Nicofran83/Proy_Final_NF/imag_readme/Imagen22.jpg

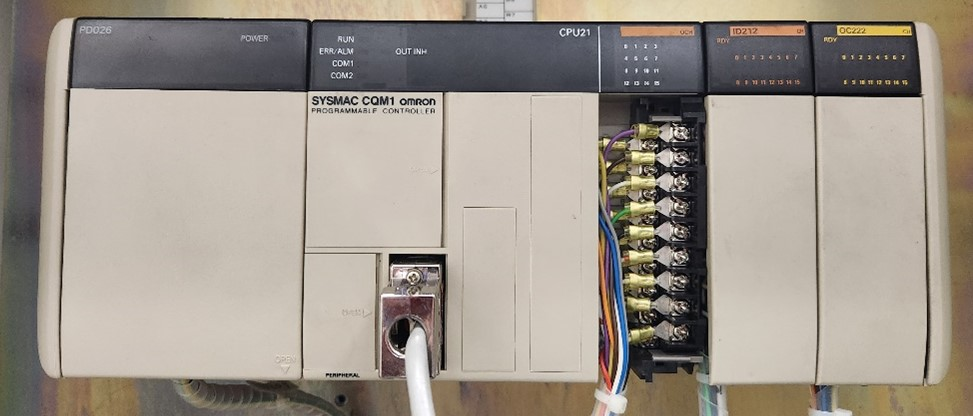
imag_readme/Imagen22.jpg
