Nicofran83/Proy_Final_NF/imag_readme/Imagen1.png

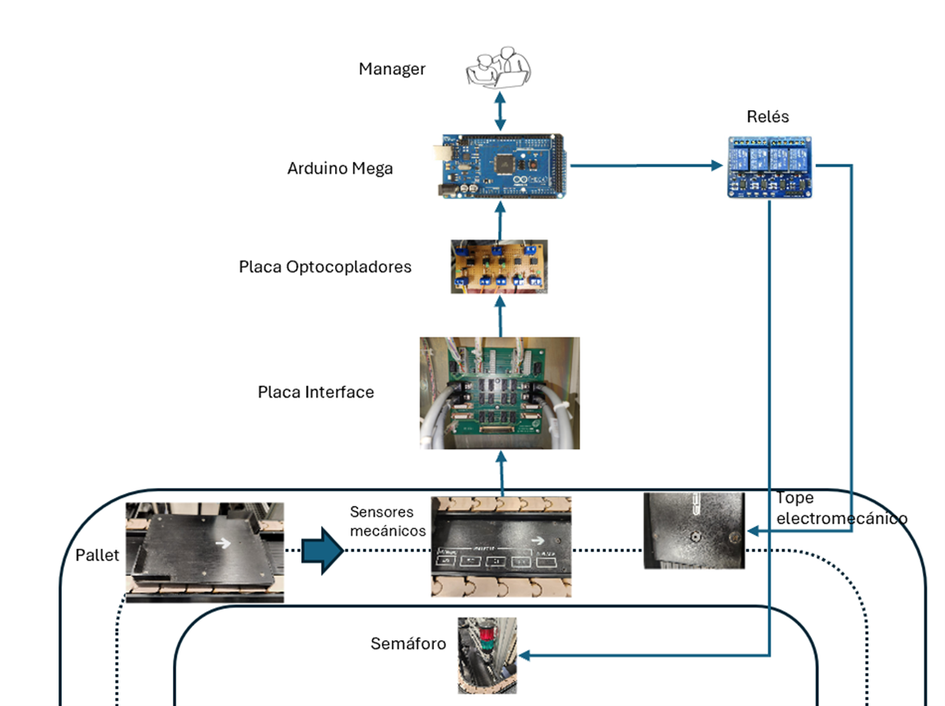
imag_readme/Imagen1.png
