Nicofran83/Proy_Final_NF/imag_readme/Imagen2.png

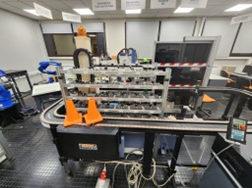
imag_readme/Imagen2.png
