Nicofran83/Proy_Final_NF/imag_readme/Imagen4.png

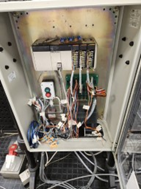
imag_readme/Imagen4.png
