Nicofran83/Proy_Final_NF/imag_readme/Imagen5.png

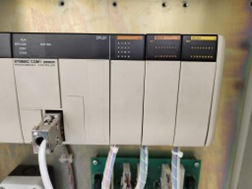
imag_readme/Imagen5.png
