Nicofran83/Proy_Final_NF/imag_readme/Imagen6.png

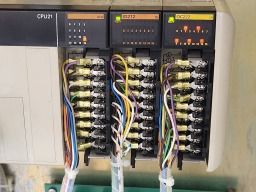
imag_readme/Imagen6.png
