Nicofran83/Proy_Final_NF/imag_readme/Imagen7.png

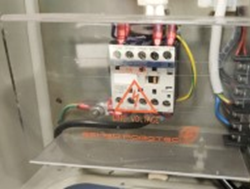
imag_readme/Imagen7.png
