Nicofran83/Proy_Final_NF/imag_readme/Imagen8.png

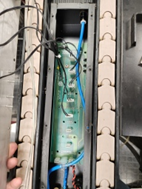
imag_readme/Imagen8.png
