Nicofran83/Proy_Final_NF/imag_readme/Imagen9.png

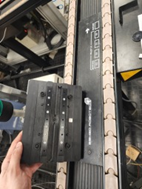
imag_readme/Imagen9.png
