Nicofran83/Proy_Final_NF/imag_readme/Imagen10.png

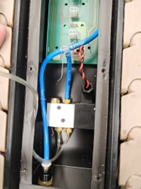
imag_readme/Imagen10.png
