Nicofran83/Proy_Final_NF/imag_readme/Imagen12.png

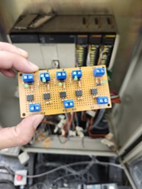
imag_readme/Imagen12.png
