Nicofran83/Proy_Final_NF/imag_readme/Imagen15.png

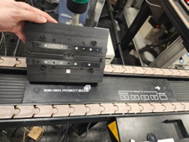
imag_readme/Imagen15.png
