Nicofran83/Proy_Final_NF/imag_readme/Imagen23.png

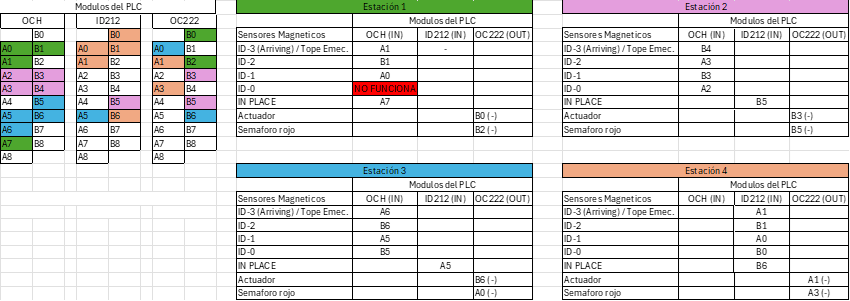
imag_readme/Imagen23.png
