Nicofran83/Proy_Final_NF/imag_readme/Imagen24.png

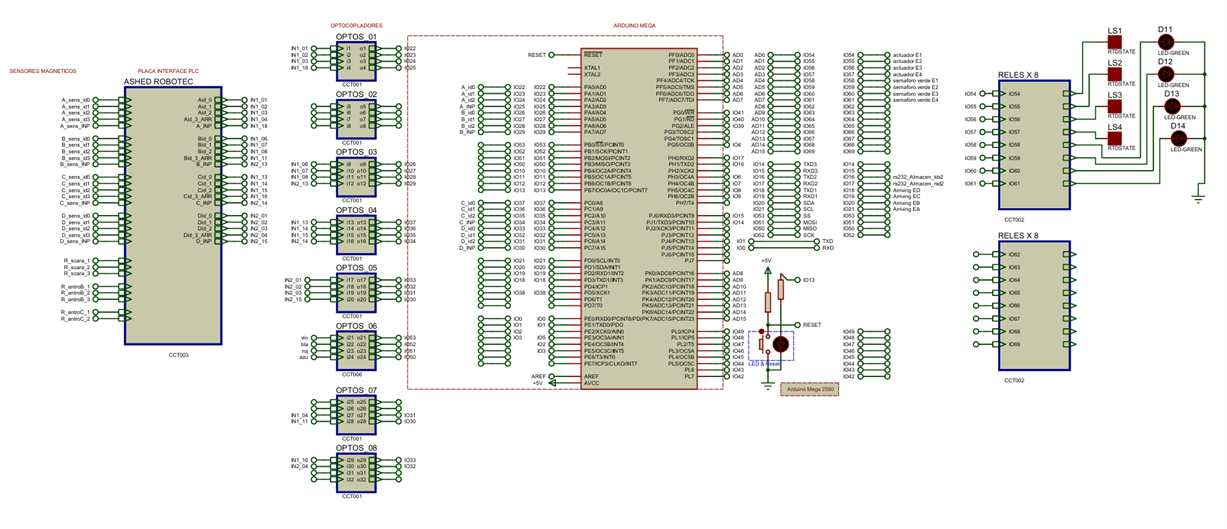
imag_readme/Imagen24.png
