Nicofran83/Proy_Final_NF/imag_readme/Imagen25.png

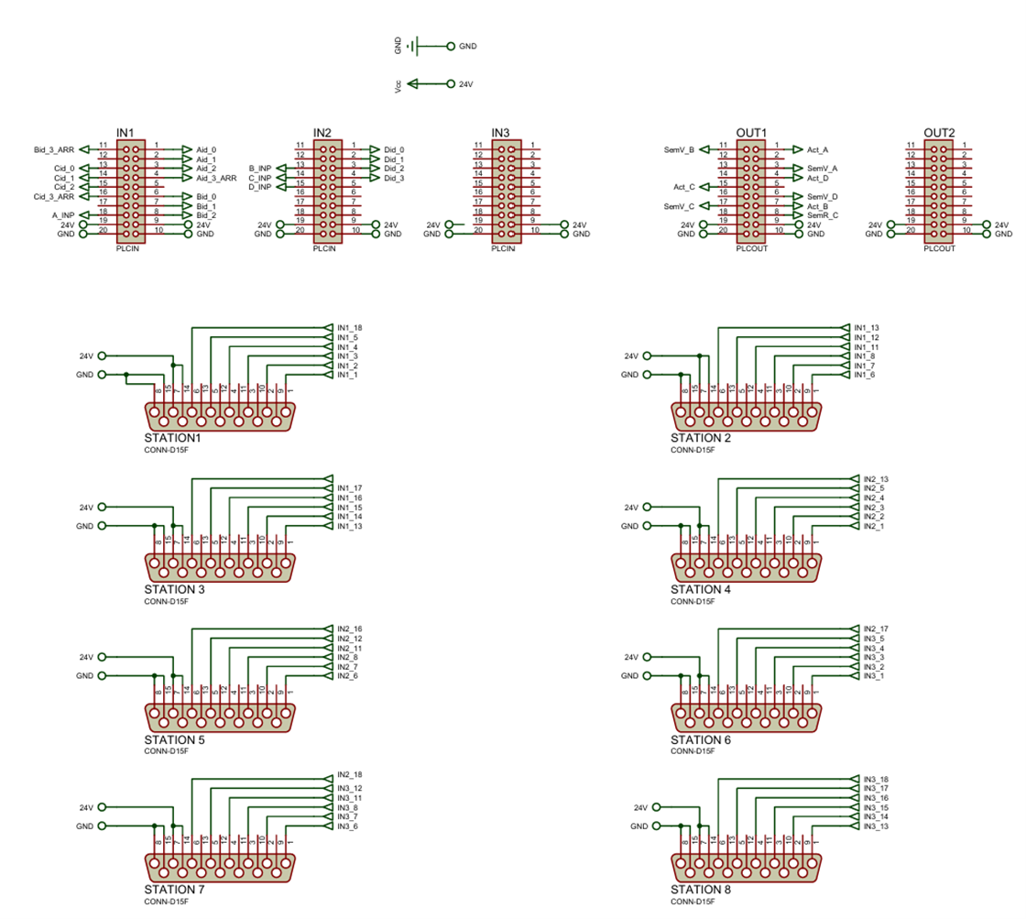
imag_readme/Imagen25.png
