Nicofran83/Proy_Final_NF/imag_readme/Imagen26.png

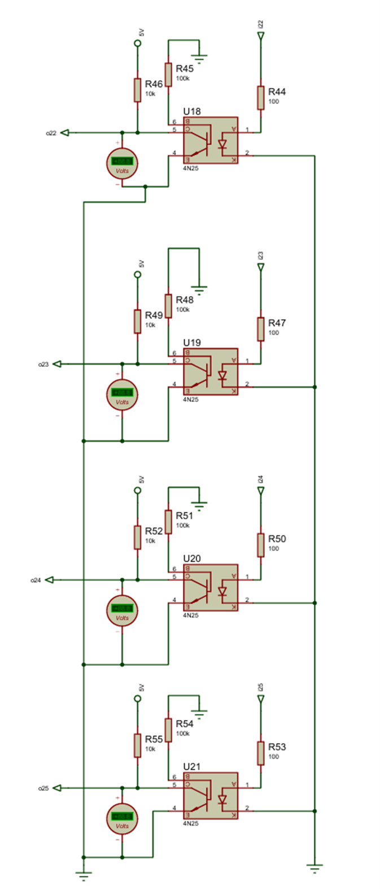
imag_readme/Imagen26.png
