Nicofran83/Proy_Final_NF/imag_readme/Imagen27.png

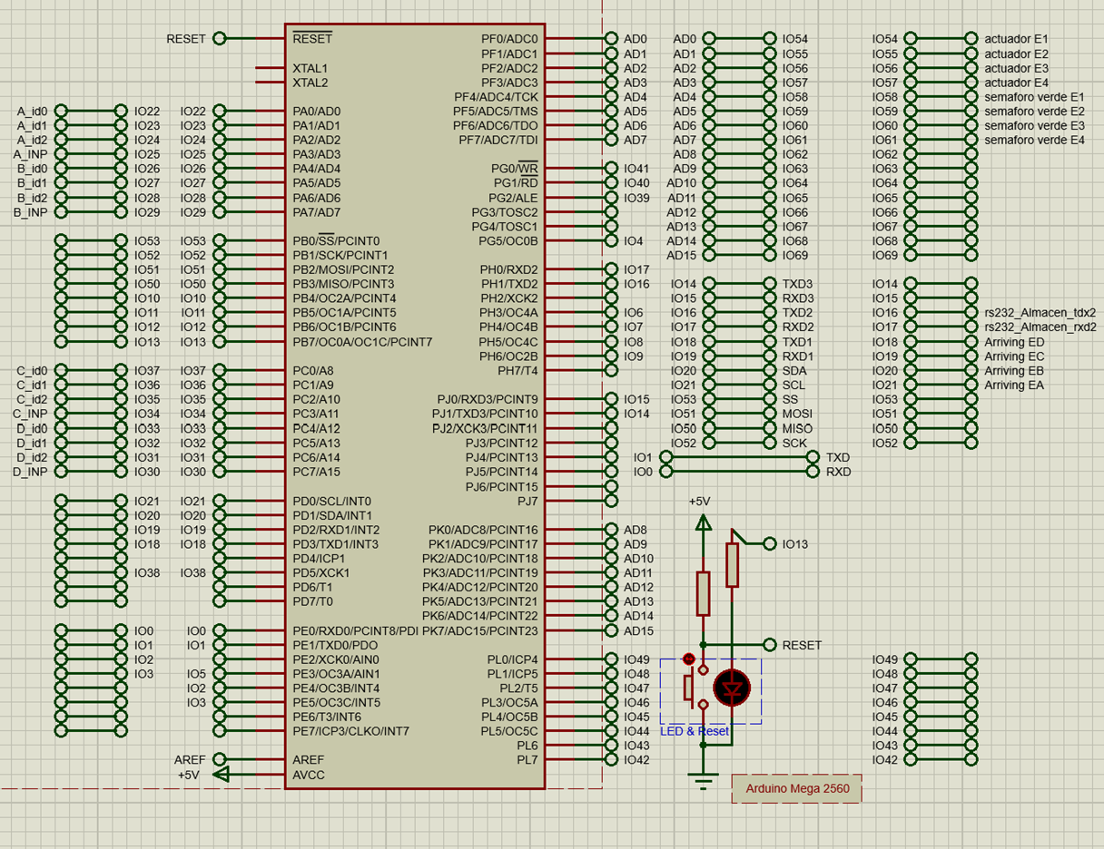
imag_readme/Imagen27.png
