Nicofran83/Proy_Final_NF/imag_readme/Imagen28.png

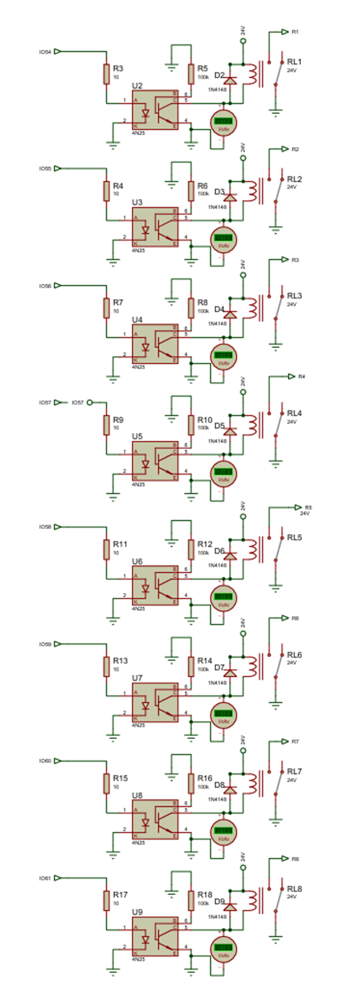
imag_readme/Imagen28.png
