Nicofran83/Proy_Final_NF/imag_readme/Imagen29.png

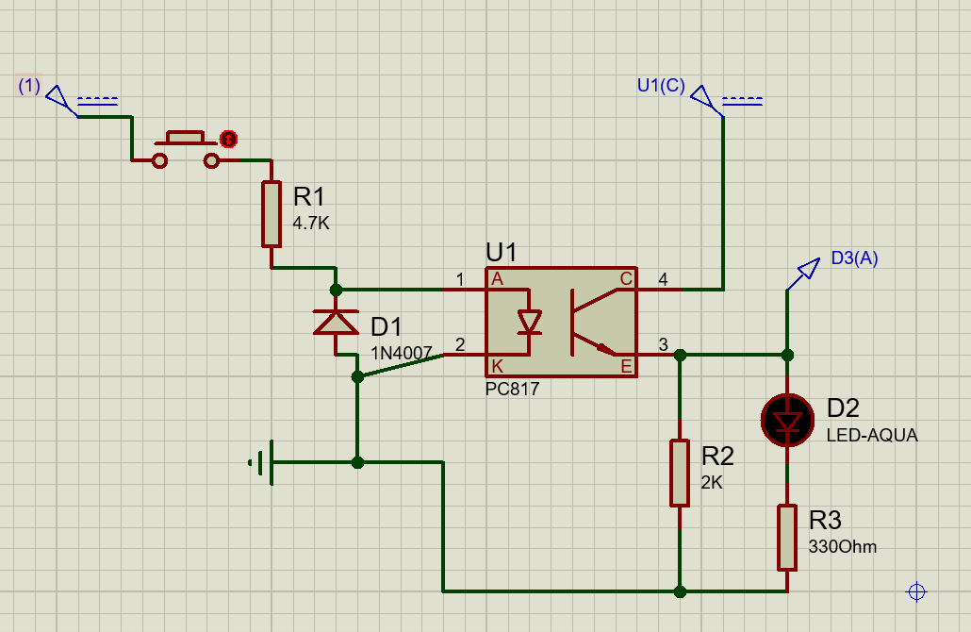
imag_readme/Imagen29.png
