Nicofran83/Proy_Final_NF/Imagenes/CIM/20240624_185640.jpg

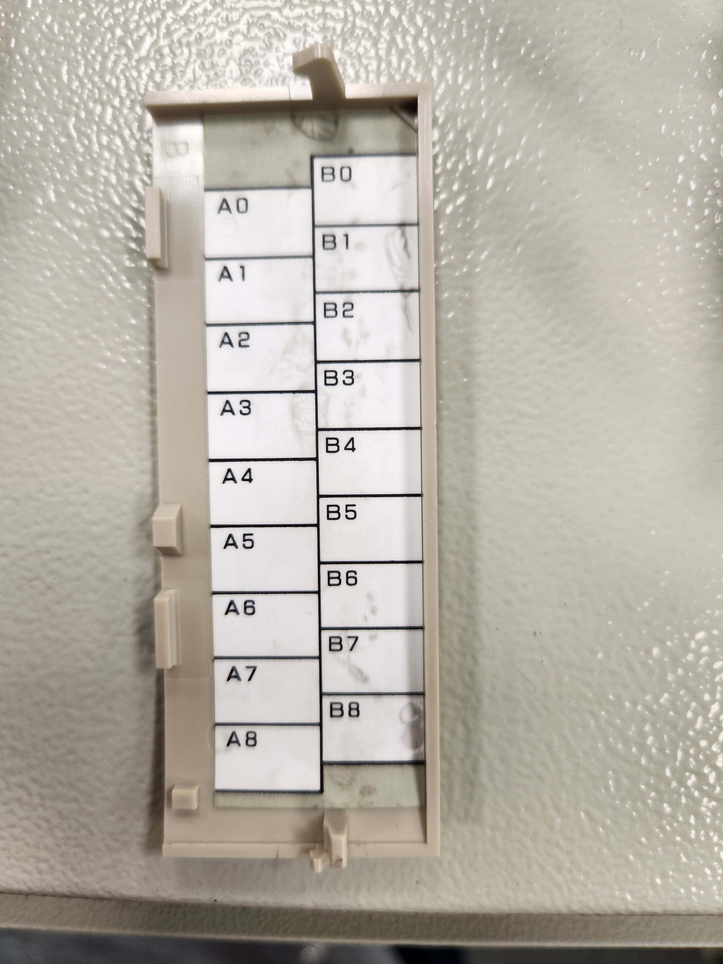
Imagenes/CIM/20240624_185640.jpg
