Nicofran83/Proy_Final_NF/Imagenes/CIM/20240624_201300.jpg

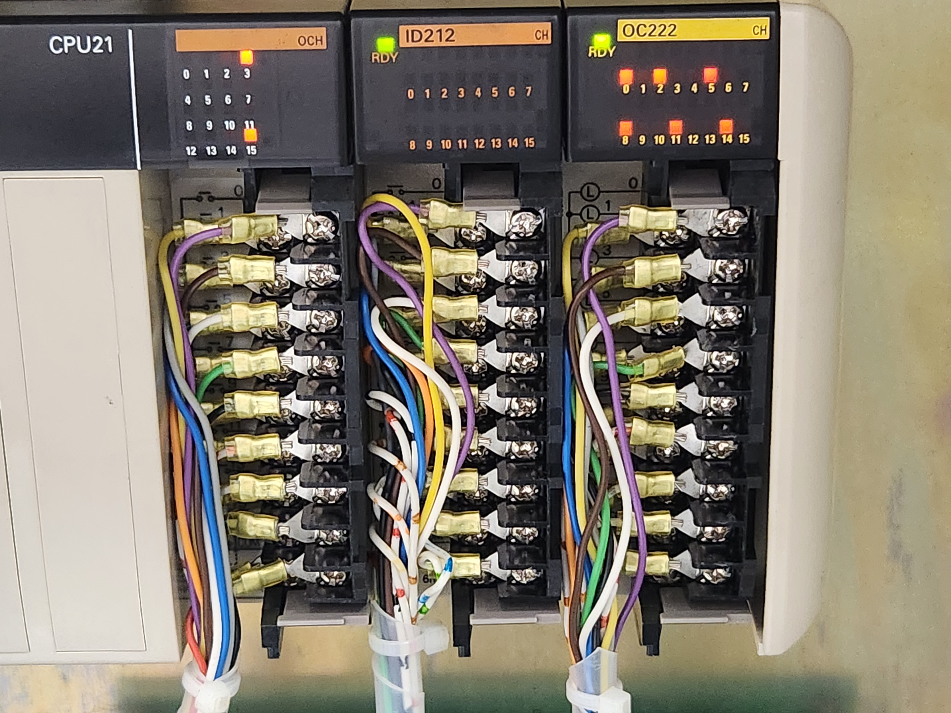
Imagenes/CIM/20240624_201300.jpg
