Nicofran83/Proy_Final_NF/Imagenes/CIM/20240708_185859.jpg

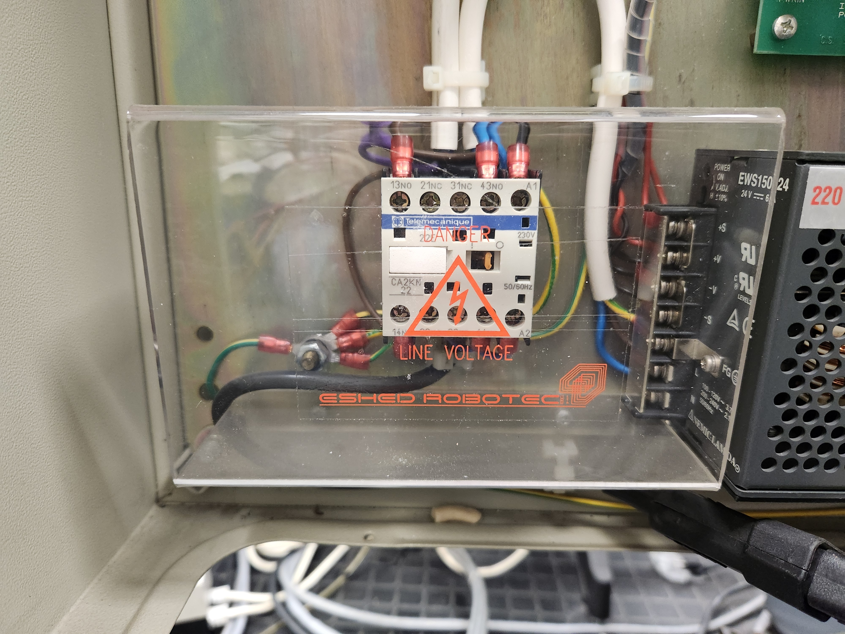
Imagenes/CIM/20240708_185859.jpg
