Nicofran83/Proy_Final_NF/Imagenes/CIM/20240708_193927.jpg

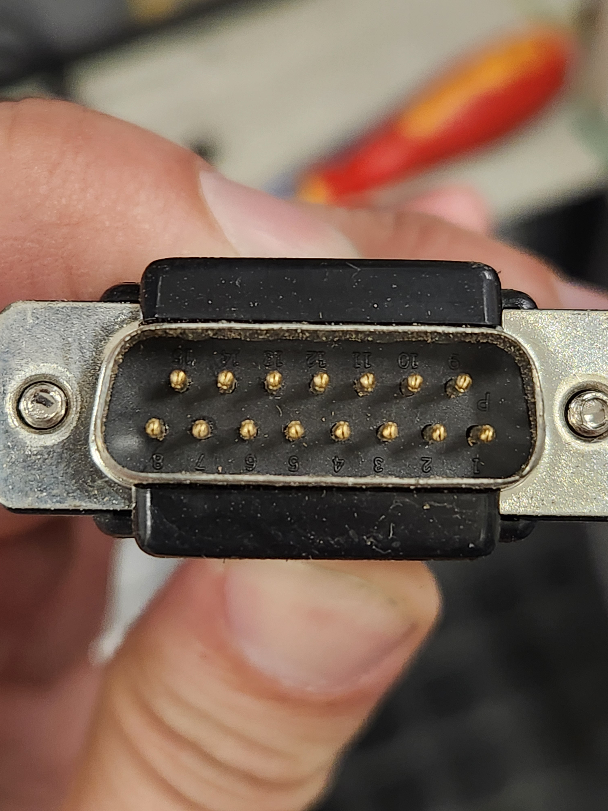
Imagenes/CIM/20240708_193927.jpg
