Nicofran83/Proy_Final_NF/Imagenes/CIM/20240708_193940.jpg

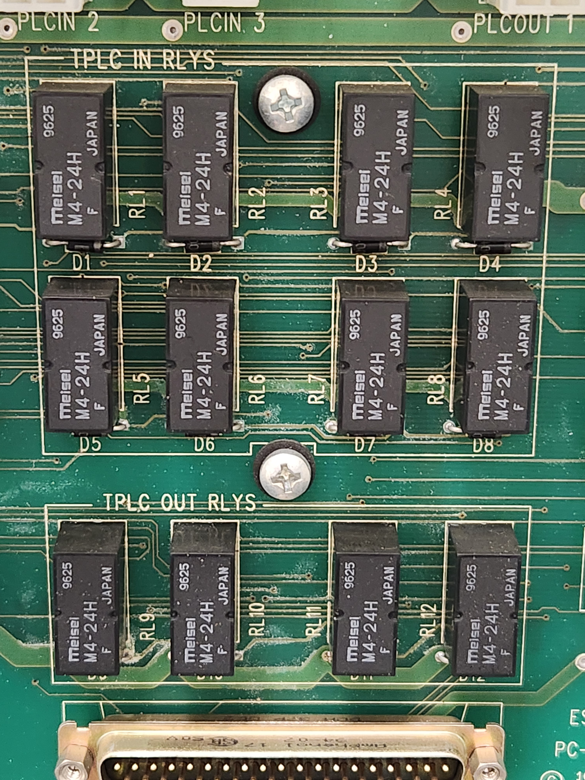
Imagenes/CIM/20240708_193940.jpg
