Nicofran83/Proy_Final_NF/Imagenes/CIM/20240909_210930_9eb32291.jpg

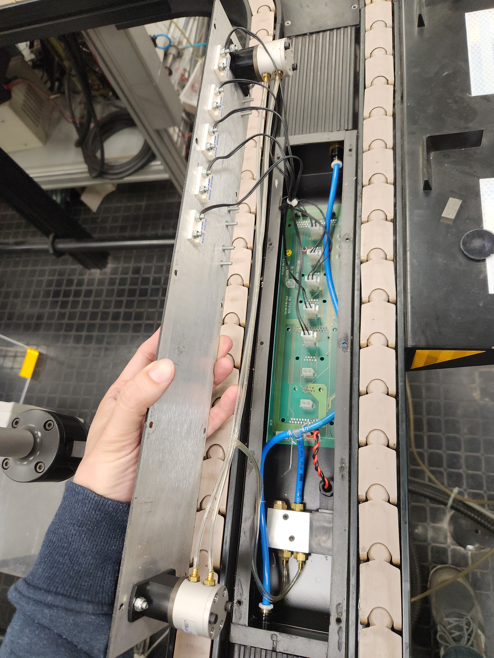
Imagenes/CIM/20240909_210930_9eb32291.jpg
