Nicofran83/Proy_Final_NF/Imagenes/CIM/20240923_190929_9bd7342d.jpg

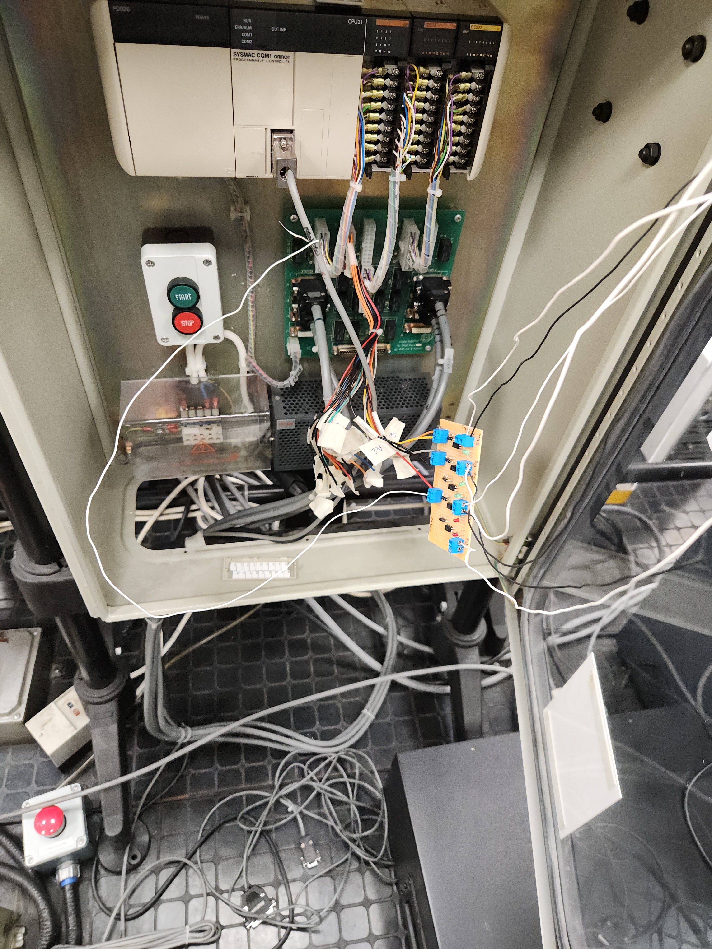
Imagenes/CIM/20240923_190929_9bd7342d.jpg
