Nicofran83/Proy_Final_NF/Imagenes/CIM/20240923_192916_5ddb27ad.jpg

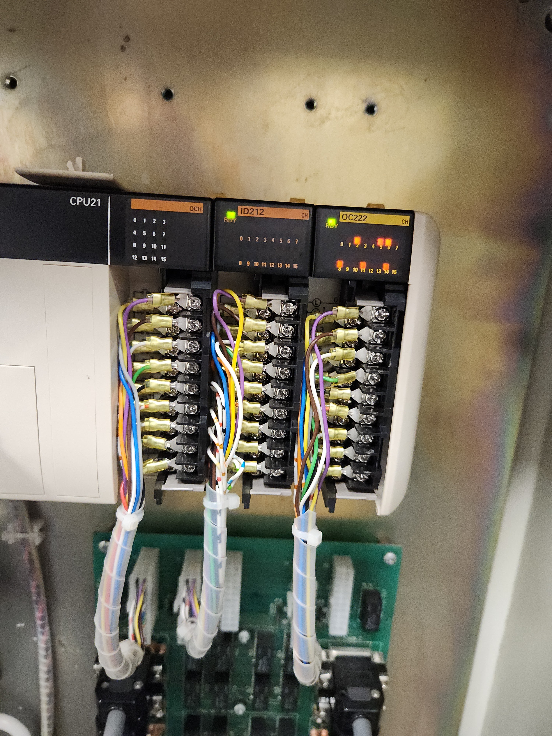
Imagenes/CIM/20240923_192916_5ddb27ad.jpg
