Nicofran83/Proy_Final_NF/Imagenes/CIM/20240923_192927_50c0e206.jpg

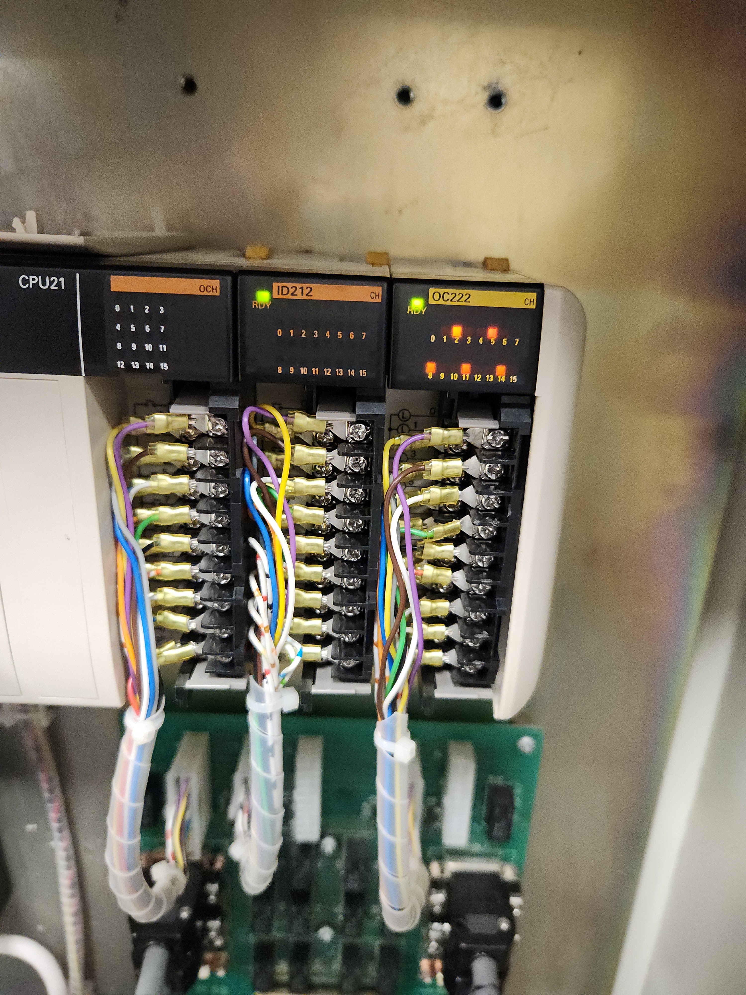
Imagenes/CIM/20240923_192927_50c0e206.jpg
