Nicofran83/Proy_Final_NF/Imagenes/CIM/20240923_210258_53427f90.jpg

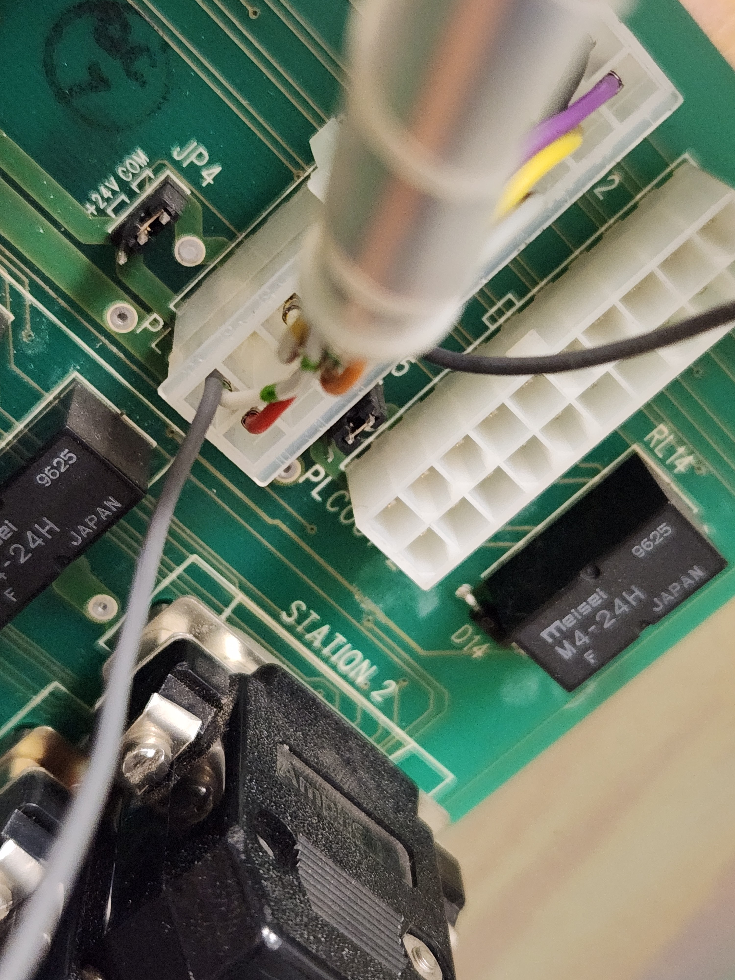
Imagenes/CIM/20240923_210258_53427f90.jpg
