Nicofran83/Proy_Final_NF/Imagenes/CIM/20240923_210310.jpg

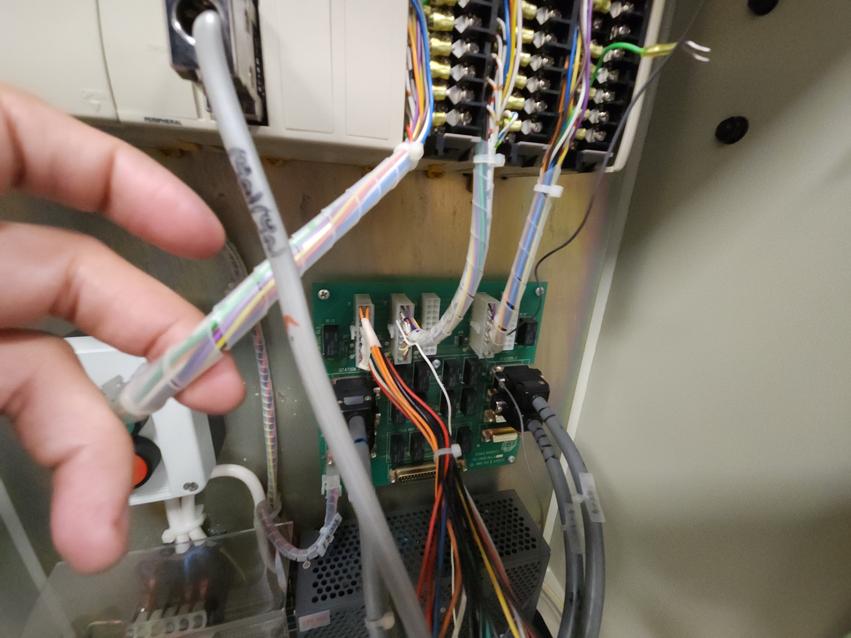
Imagenes/CIM/20240923_210310.jpg
