Nicofran83/Proy_Final_NF/Imagenes/CIM/20241007_211003_5ba95c5c.jpg

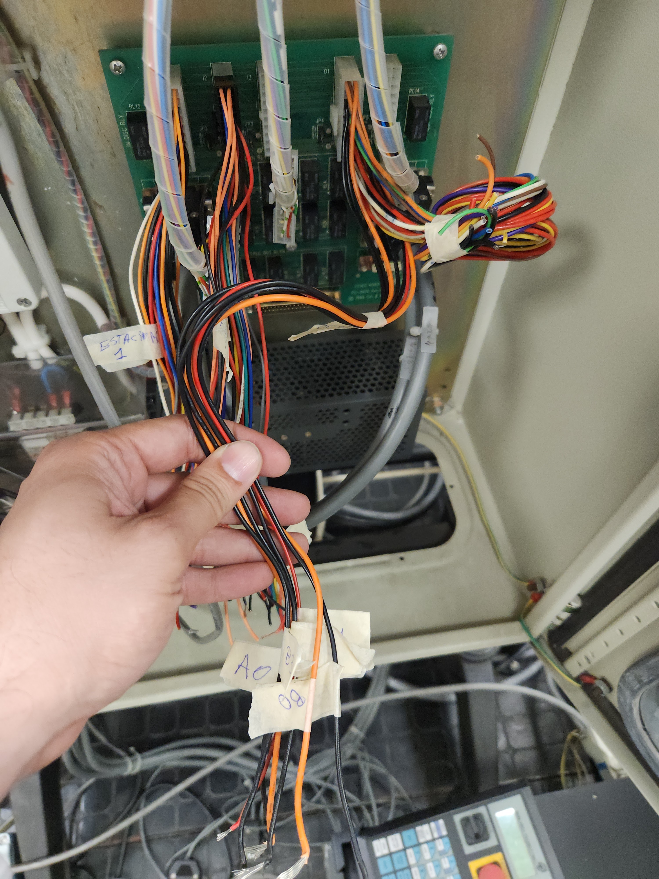
Imagenes/CIM/20241007_211003_5ba95c5c.jpg
