Nicofran83/Proy_Final_NF/Imagenes/CIM/20250415_193251.jpg

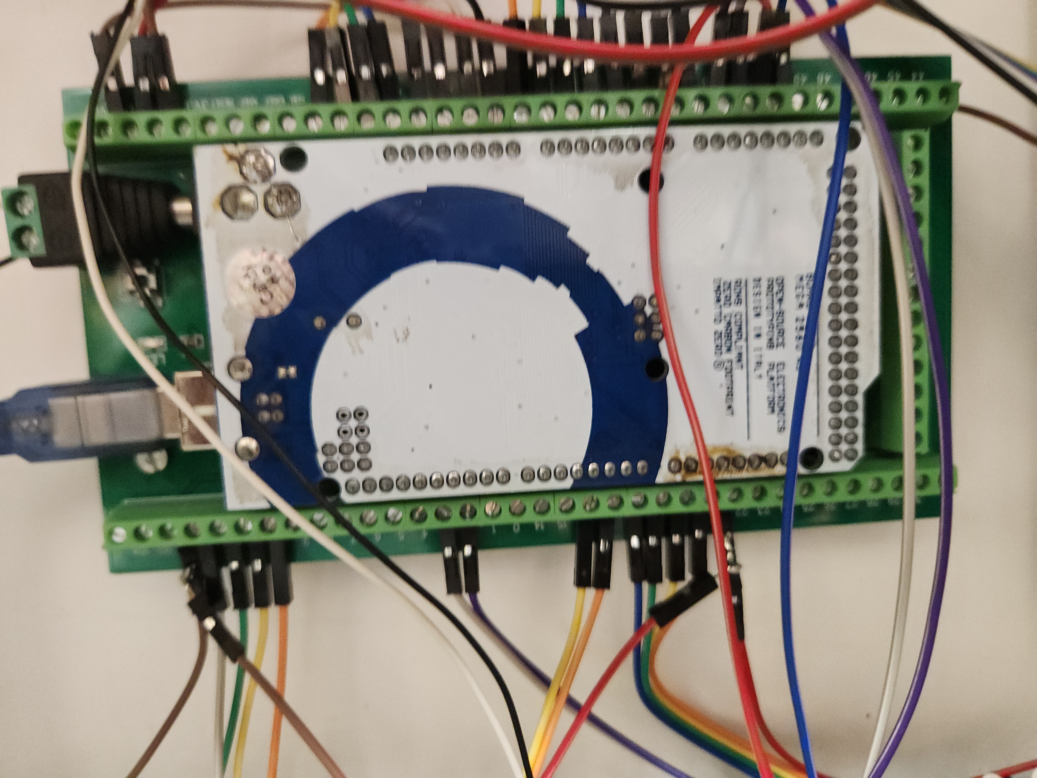
Imagenes/CIM/20250415_193251.jpg
