Nicofran83/Proy_Final_NF/Imagenes/CIM/20250415_193316.jpg

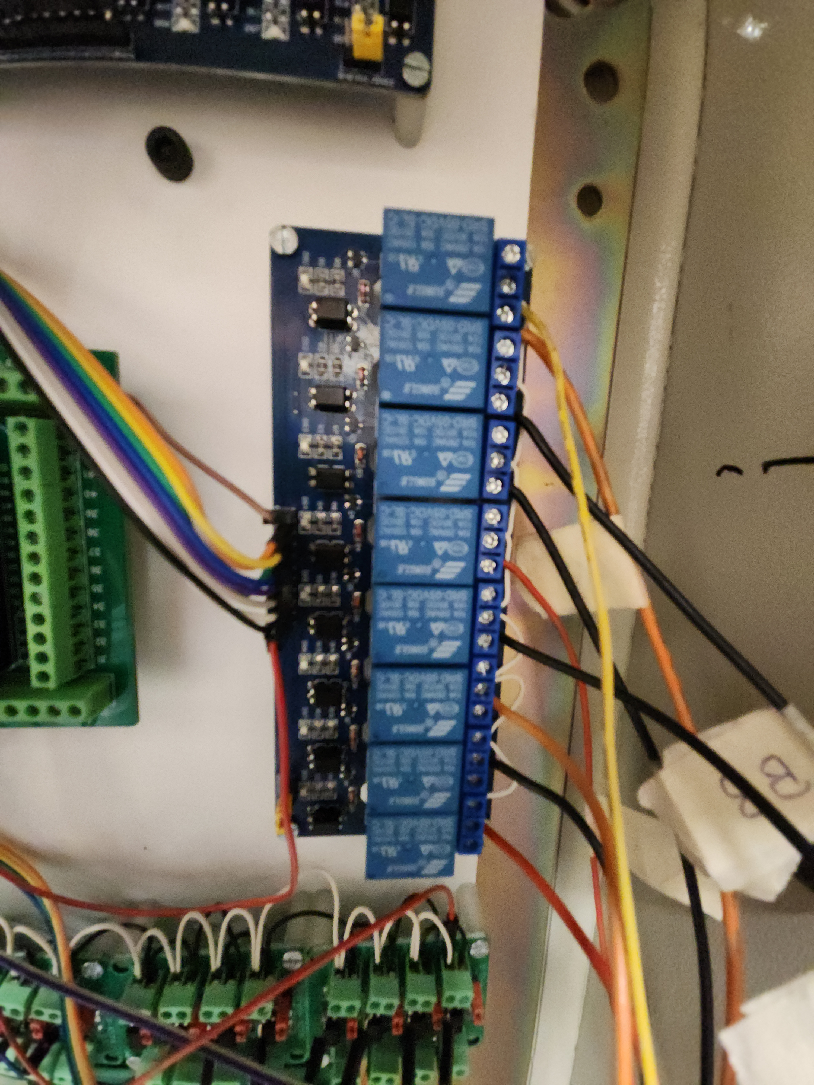
Imagenes/CIM/20250415_193316.jpg
