Nicofran83/Proy_Final_NF/Imagenes/CIM/20250510_091335.jpg

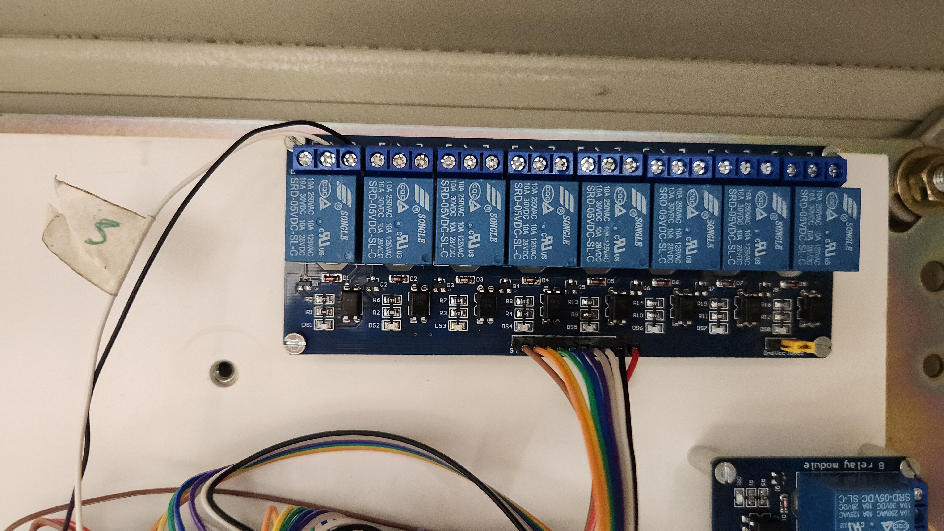
Imagenes/CIM/20250510_091335.jpg
