Nicofran83/Proy_Final_NF/Imagenes/CIM/20250510_091654.jpg

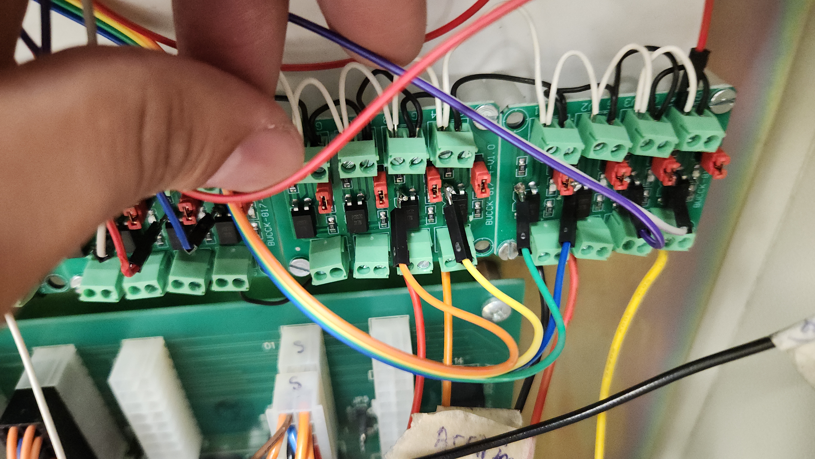
Imagenes/CIM/20250510_091654.jpg
