Nicofran83/Proy_Final_NF/Imagenes/CIM/20250510_102802.jpg

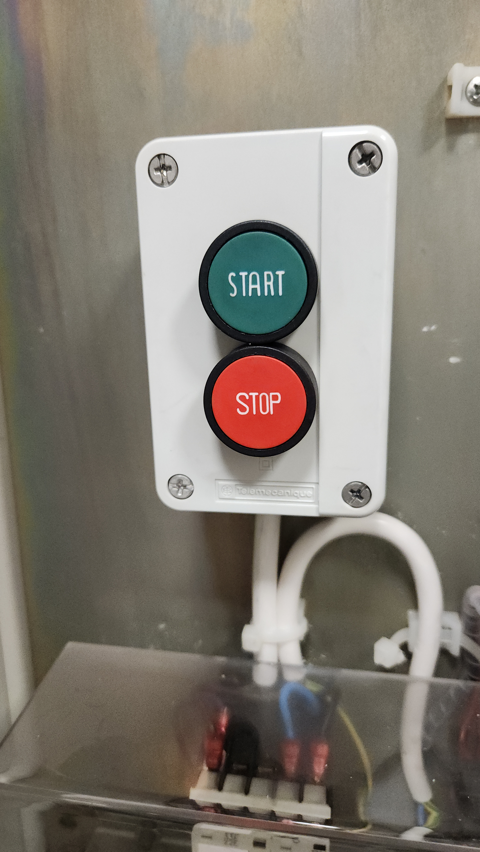
Imagenes/CIM/20250510_102802.jpg
