Nicofran83/Proy_Final_NF/Imagenes/CIM/20250510_125914.jpg

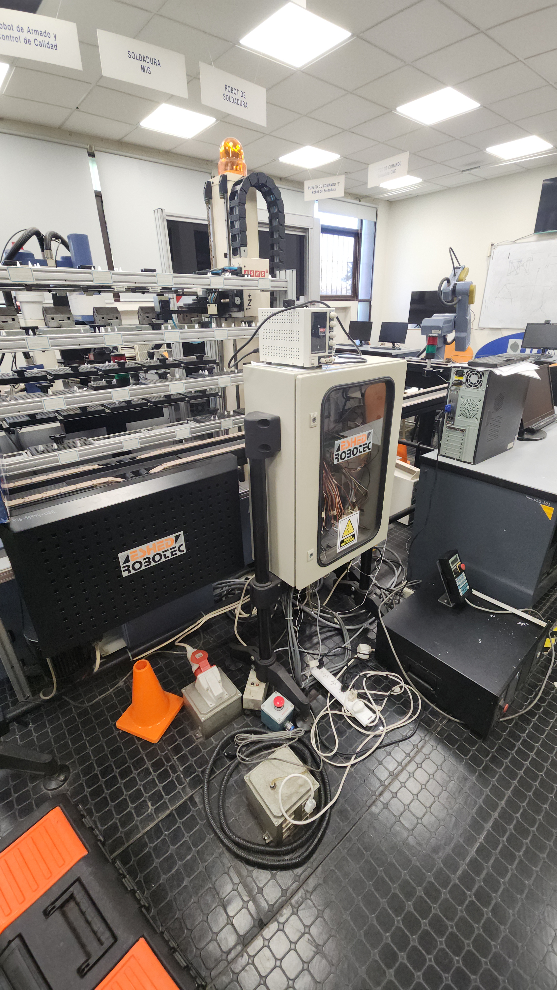
Imagenes/CIM/20250510_125914.jpg
