Nicofran83/Proy_Final_NF/Imagenes/CIM/20250517_122136.jpg

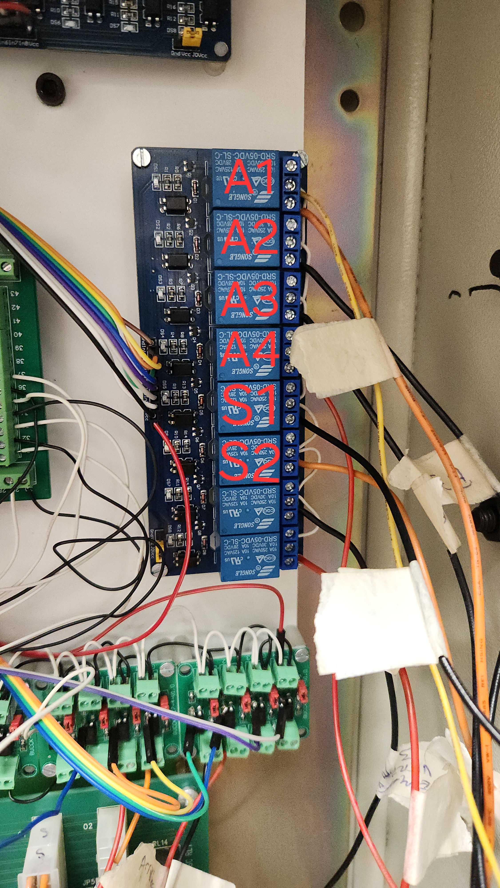
Imagenes/CIM/20250517_122136.jpg
