Nicofran83/Proy_Final_NF/Imagenes/CIM/20250528_205753.jpg

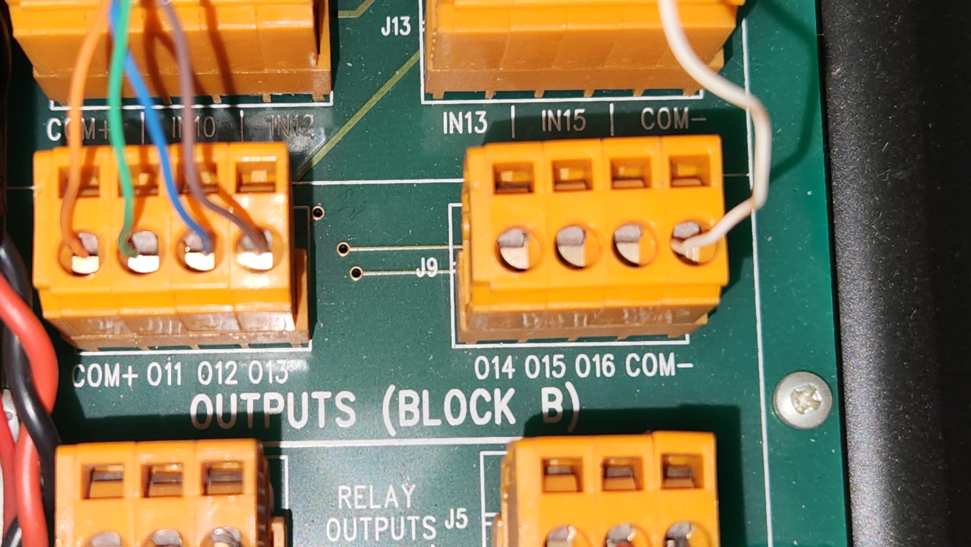
Imagenes/CIM/20250528_205753.jpg
