Nicofran83/Proy_Final_NF/Imagenes/CIM/20250528_210424.jpg

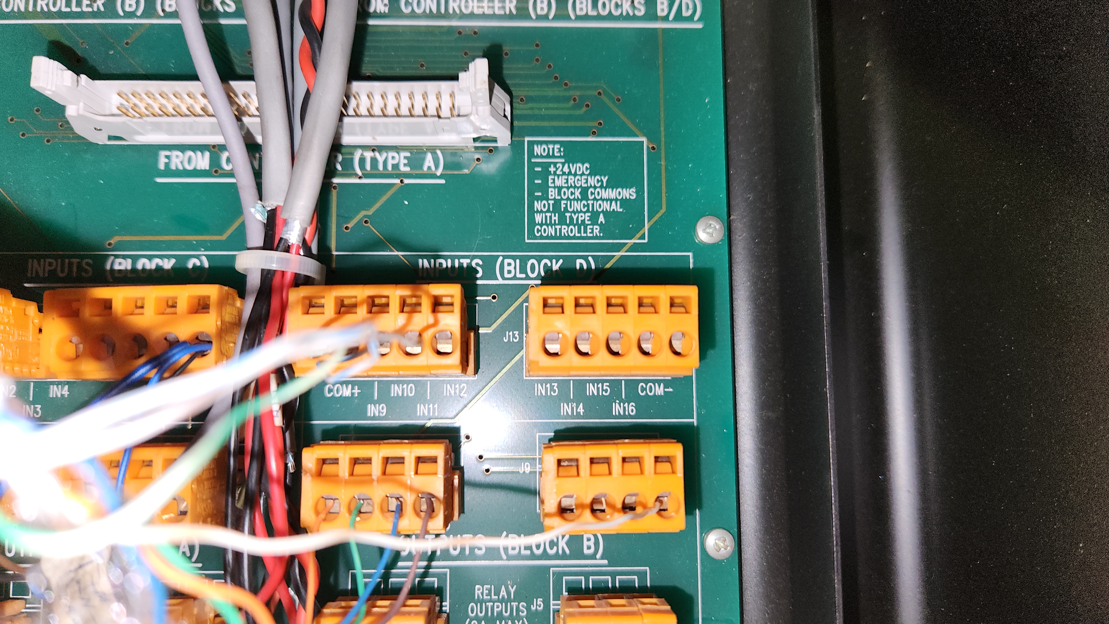
Imagenes/CIM/20250528_210424.jpg
