Nicofran83/Proy_Final_NF/Imagenes/CIM/20250531_105511.jpg

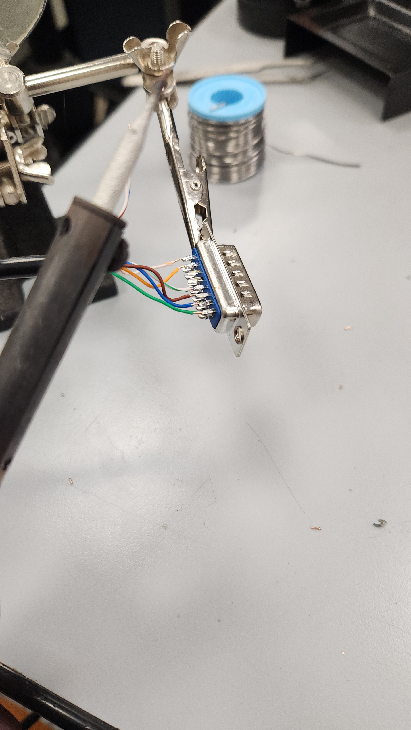
Imagenes/CIM/20250531_105511.jpg
