Nicofran83/Proy_Final_NF/Imagenes/CIM/20250604_210156.jpg

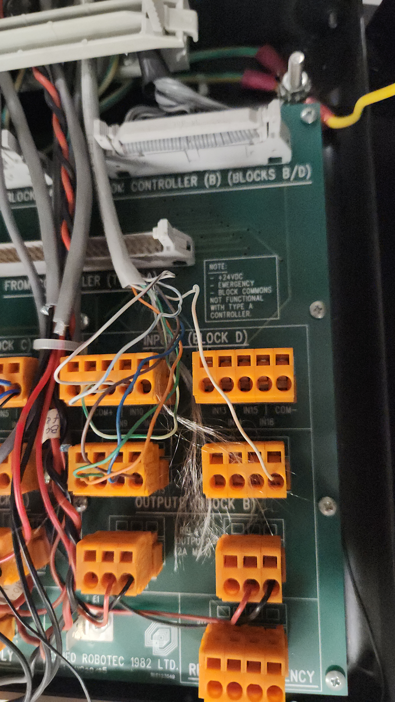
Imagenes/CIM/20250604_210156.jpg
