Nicofran83/Proy_Final_NF/Imagenes/CIM/20250609_185502.jpg

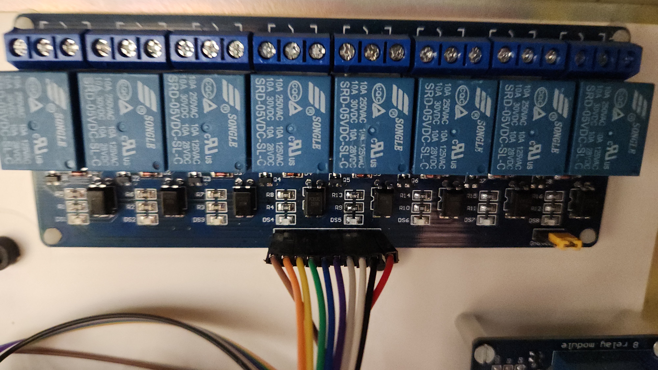
Imagenes/CIM/20250609_185502.jpg
