Nicofran83/Proy_Final_NF/Imagenes/CIM/20250609_185510.jpg

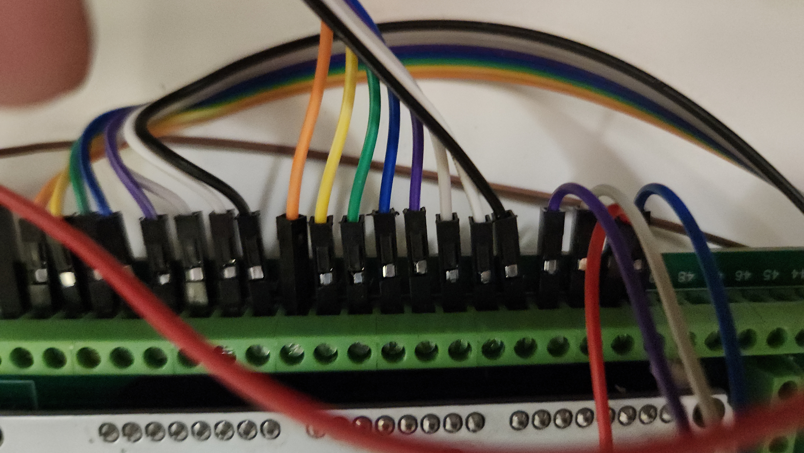
Imagenes/CIM/20250609_185510.jpg
