Nicofran83/Proy_Final_NF/Imagenes/CIM/20250609_185539(0).jpg

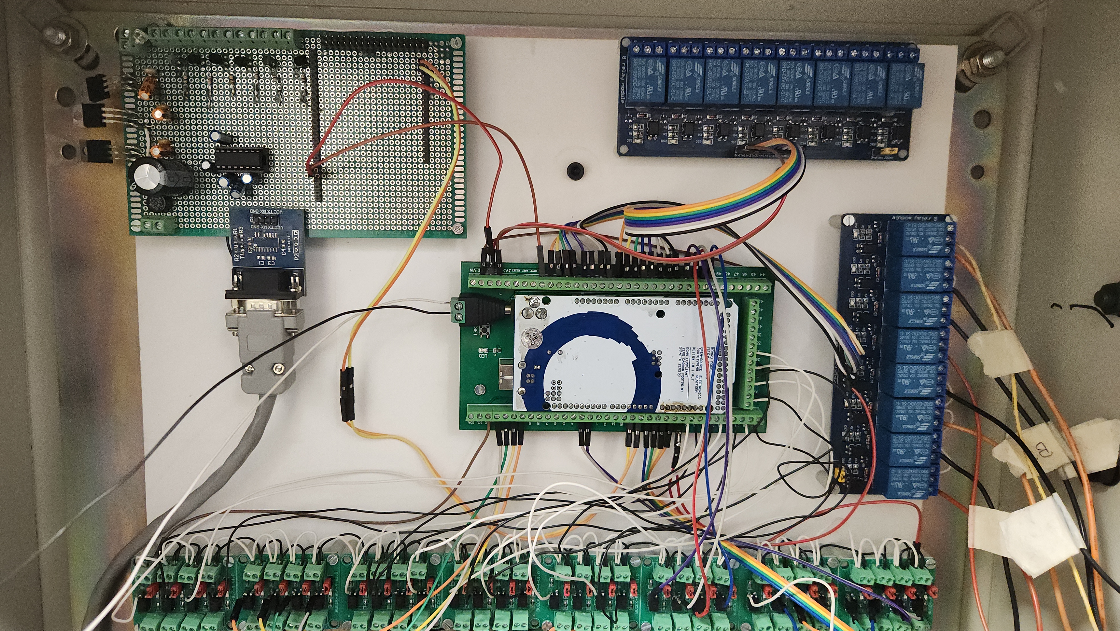
Imagenes/CIM/20250609_185539(0).jpg
