Nicofran83/Proy_Final_NF/(list of files, drawings)

Other design files:
Planos electricos Proteus/Control_CIM_20250630.pdsprj
