Nicofran83/Proy_Final_NF/(commit log)

2025-07-22 nuevo repositorio - primer commit
    [Control_CIM_20250630.pdsprj]
2025-07-23 Create README.md
    carga de imagenes
