Nicofran83/Proy_Final_NF/Imagenes/CIM/20240708_204007.jpg

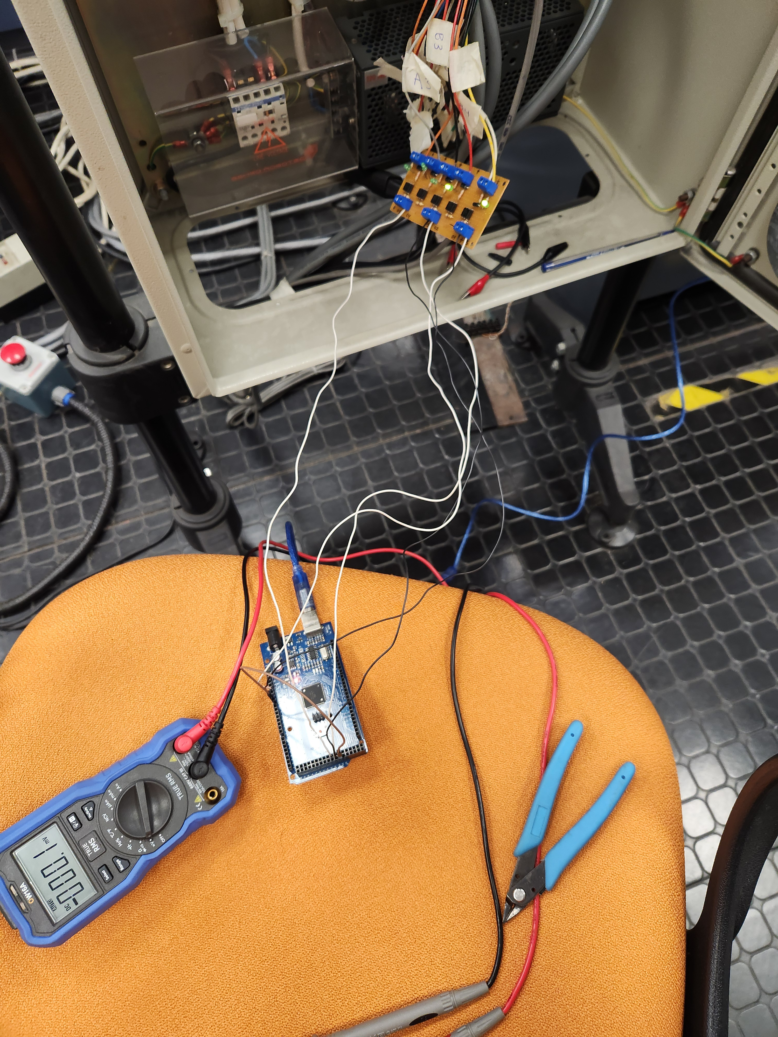
Imagenes/CIM/20240708_204007.jpg
