Nicofran83/Proy_Final_NF/Imagenes/CIM/20240909_210934.jpg

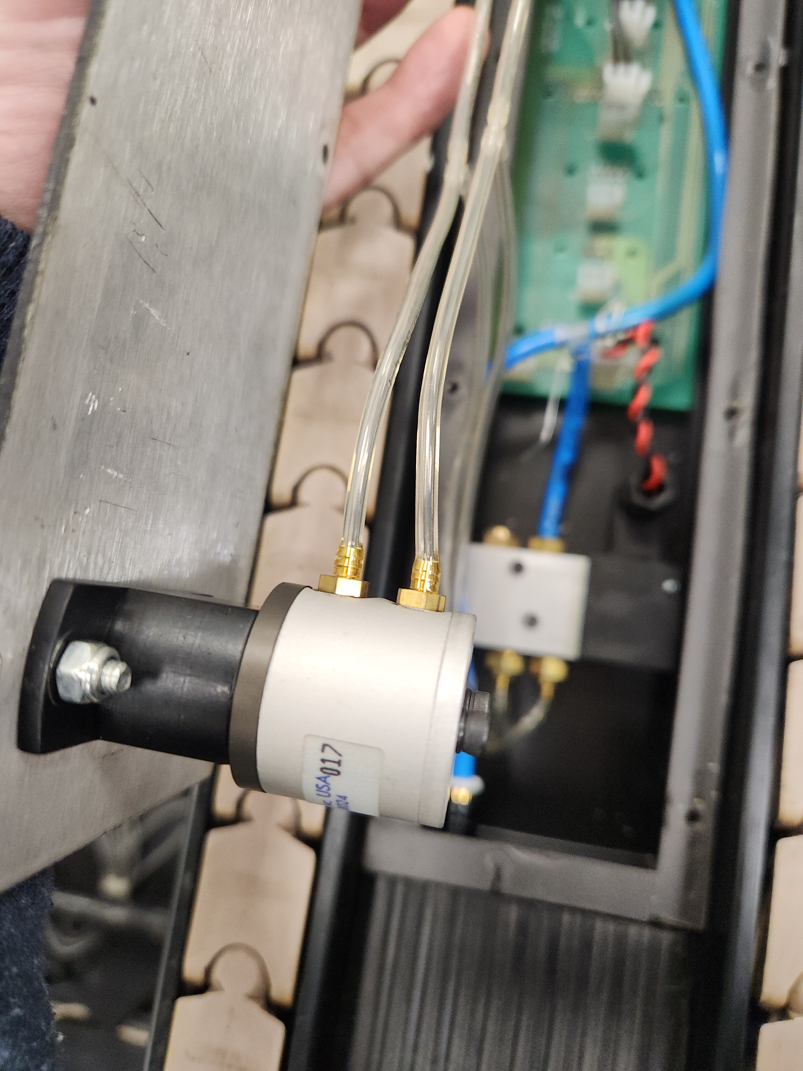
Imagenes/CIM/20240909_210934.jpg
