Nicofran83/Proy_Final_NF/Imagenes/CIM/20240909_210937.jpg

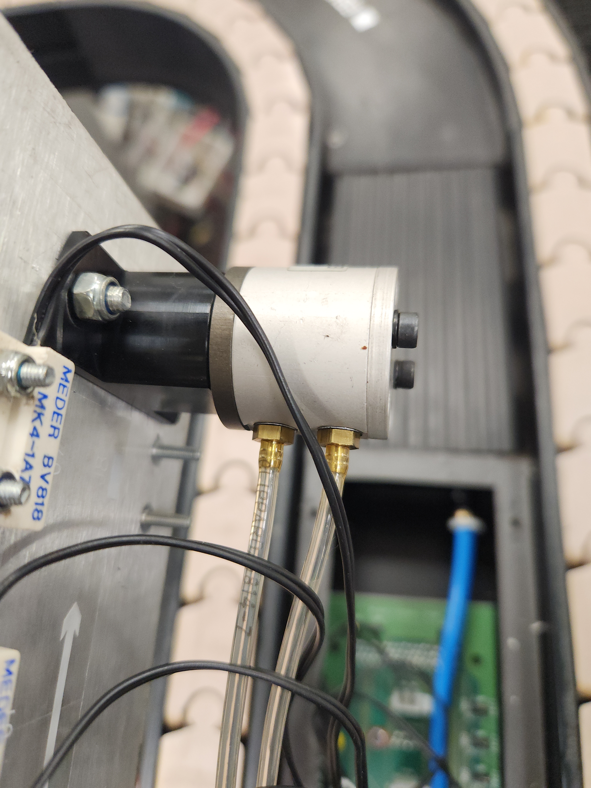
Imagenes/CIM/20240909_210937.jpg
