Nicofran83/Proy_Final_NF/Imagenes/CIM/20241007_210952.jpg

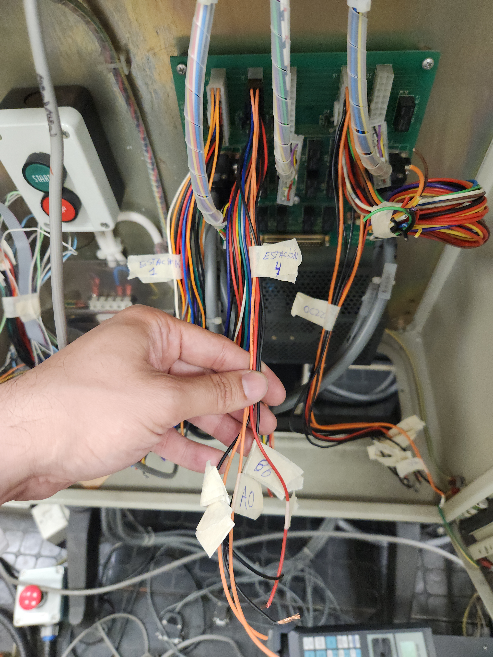
Imagenes/CIM/20241007_210952.jpg
